Lyric0423/tianyuandifang/要求.md

请大家设计一个亚克力板的结构，具体要求如下：

1. 绘图要求：
要求画出“圆和方”。圆和方必须是同心的，但相不相交随意（可以是独立的，也可以是内接或外切的），大小不限。但是，最后做出来的结果至少要比较显著，因为画得太小也不好做。别说“陈老师，我最后用方头笔杵一下就算是方”，这不行，是要走出轨迹来的。

2. 电机配置：
因为是两个同学合作，一共有 4 个电机。你们用 2~3 个电机即可，具体配置可以是“两个步进电机加一个舵机”，也可以是“两个舵机加一个步进电机”，随便你们安排。

3. 操作工具：
完成的目标是操作一支笔或者笔芯。如果你自己有，随便用什么笔都可以。但除了那些“耍赖”的（比如毛笔之类的不算），必须使用正常的硬笔，具体是圆珠笔、水笔、铅笔都行。

4. 材料要求：
用的材料还是我们前面用过的那种，2.7mm 左右的亚克力板。一共是有两次机会。整个完成过程，包括下星期和下下星期，都是我们在课堂里的制作过程。

(a) 亚克力板：在加工之前，我会用千分尺测量好大概的尺寸给大家。
(b) 螺母和螺杆：允许使用，由我会提供。都是 3mm 的（叫 M3），长度有 1cm、2cm、3cm、4cm 的我都有。
(c) 橡皮筋：允许使用。
(d) 热熔胶：允许使用我们刚才用的热熔胶。
(e) 自备胶带和胶水：这次允许大家自备。

作业/第二次作业/Gear+Bar.dxf
这是一套齿轮和齿条，供参考。其中齿轮的轴就是步进电机的轴。

当然，还是那句话，允许你使用，但别太过分！你别跟陈老师说：“那亚克力板我就不用了，我全用热熔胶，一节课我就用一胶，垒出一个结构来。”别太过分，适可而止，让我还是能看得到你是拿亚克力板做的东西。你别跟陈老师说：“我热熔胶上粘了一小块亚克力，意思一下。”你别太过分，别的都行。

希望大家画出来的作品能够有完成度，就是画出来的圆和方看起来就是圆和方，越方越好，越圆越好。你别画出来的圆像方，画出来的方像圆，最后还跟陈老师说：“你看着办，哪个算是圆都行。”那不行啊，你要能让肉眼看得清楚是什么。

关于评分标准：
1. 创新部分：别出心裁的想法占 30 分。
2. 完成度部分：占 70 分。
换句话说，就算你最后没有达成目标，但是你的想法挺不错的，那在创新和创意想法这块占的分会比较高的，别太担心啊，别太担心。

最后，关于具体怎么做，我不做限制：
1. 不限制画的尺寸，几厘米到几十厘米都允许。
2. 但你别跟陈老师说：“我这车在这个房间里面走了一圈，然后在地上画了一个大大的圆，再画了一个大大的方。”我做了一个小车子，拖着一根笔在地上走。但别太过分啊，画的范围大概是一张 A4 纸，最多 A3 纸。A4 纸我当然多的是，A3 纸我们也能供得上。大概就是这么一个背景。

好，对于这个题，各位同学先问一下有没有问题？现在有疑惑的地方随时举手。

有没有 M3（直径 3mm）的？你说可以操作计算机，但机械的部分最好不要动，因为最后还是要拍录像的。

我也跟大家说一下去年完成的情况：
1. 有厉害的同学做完了之后，是完全不用操作的，车子自己就能在那跑完。
2. 有的同学因为车子绕一圈的时候线会打结，最后就抱着个笔记本跟着车转过去。

所以，后来我们在正式测量的时候定了一个规矩：你可以抱着笔记本走一圈。或者，你也可以动点脑筋，把线设计得完全不打结。但是，你的线必须是软的状态。你别最后是拎着个东西走了一个方，那是不行的啊，线得是软的，听明白了吗？

整个绘制过程要求最长 10 分钟。就是为了避免大家说“陈老师你等着，你等着”，等到下课的时候还在那走，那不行啊。最后录像你不能给我看一个超过 10 分钟的视频。

关于轨道，什么叫轨道呢？意思就是你可以在亚克力板上面掏一个圆或者方的槽，然后一根笔是松的，就这么沿着槽走一圈，把亚克力板当做尺子一样来用。这样是可以的，都可以。

还有几种特例情况我们先说清楚。我开学的时候跟大家说过，你必须得用一张普通的纸。普通的纸什么意思呢？你不能说“陈老师，我从网上随便找了一张一面是光面的纸”。我用刀在这个纸上刻了一个槽，然后拿支笔，哎呀好粗好粗地在上面“刷刷刷”刷，反正有槽的地方就有印子，这种是不行的，不允许啊！我要能看得到，你是确实按照圆和方去走的。

就这样啊，你说可以不用给笔记本供电，觉得拖着 USB 线太麻烦，要找个充电宝，这个是可以的。这次的样例，固件还是有要求的。这次给的尺寸比上次大一倍，接近 20cm×20cm，大概就是这么方，尺寸大一点，但仍然是有限制的啊！设计得渣的话还是放不下的。

你说必须什么？圆和方必须是同心的。具体是圆在外、方在外都可以，相不相交都可以。怎么了？橡皮泥是那种好像 3mm 宽的橡皮筋，我等会儿可以给你个样。你可以接啊，数量不限，什么都没有限制。但还是那句话，别太过分！你别说：“陈老师，你给我一吨。”还是有 2mm 的限制啊，还是 2mm。

你说老师，全程这个笔只能安装在设施的一个地方，还是允许画一半把笔拆下来，安在另外一个地方？

整个画的过程，机械的部分手不准碰，浩浩啊，手不准碰！但是，如果你说这个系统里面就是要两支笔，你同时装了两支笔，可以明白我的意思吗？动的时候，你可以碰电线的部分，但是不能去动机械的部分啊。

还有什么好的，大家有疑问的话还可以在群里面继续问啊。现在我们正常分组，来看看大家，祝愿一下，希望分到一个强有力的队友。
