Lyric0423/tianyuandifang/XY绘图机/图纸/02_编号排版.png

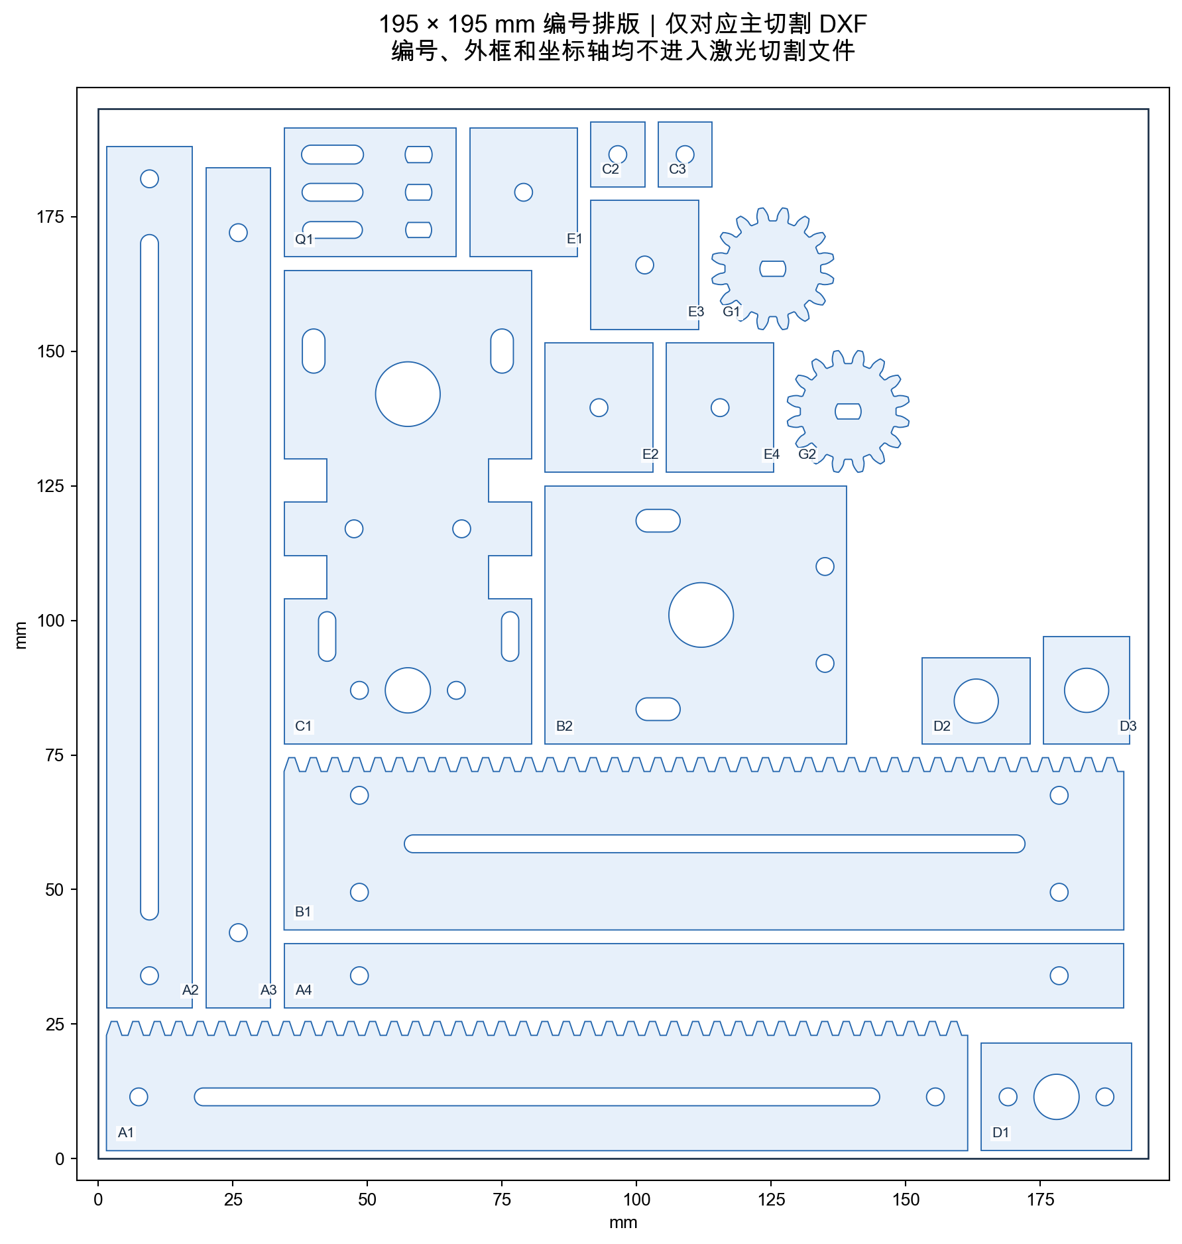
XY绘图机/图纸/02_编号排版.png
