Lyric0423/tianyuandifang/微信图片_20261104220640_549_7188.png

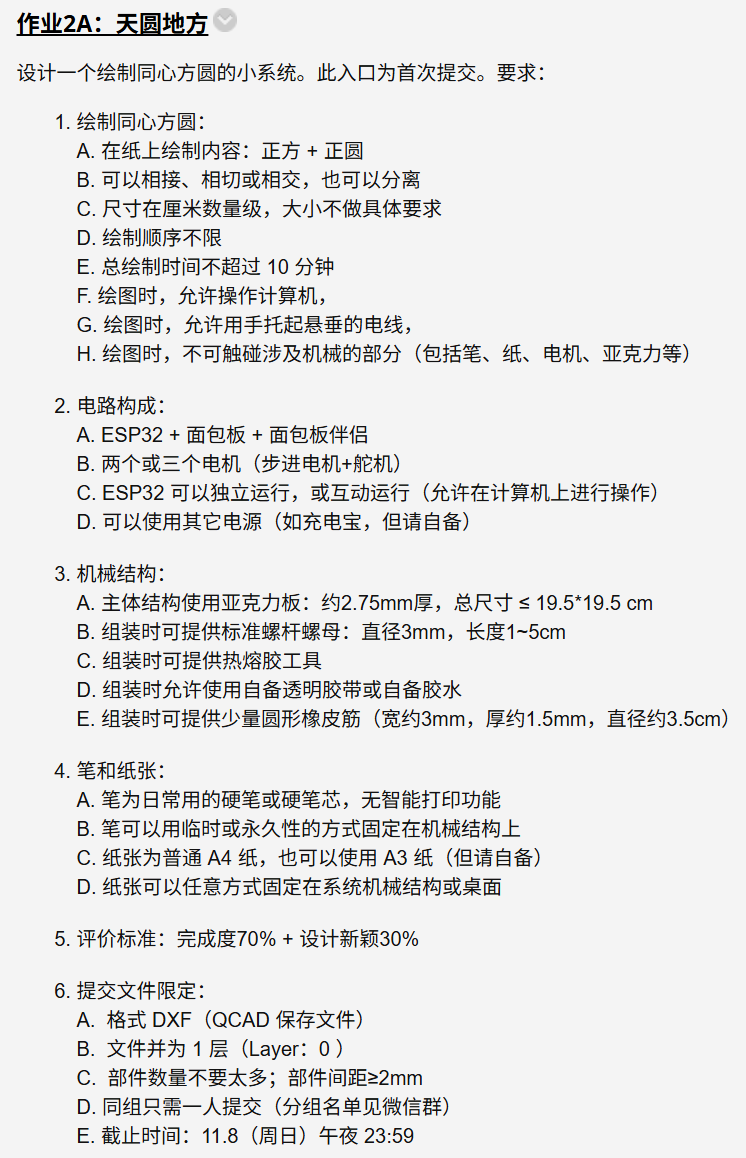
微信图片_20261104220640_549_7188.png
