Lyric0423/tianyuandifang/XY绘图机/图纸/零件孔位.csv

编号 | 名称 | 外包长mm | 外包宽mm | 孔号 | 孔类型 | 局部坐标与尺寸mm | 装配备注
A1 | Y左齿条导轨 | 160 | 24 | 1 | slot | {"type": "slot", "start": [18, 10], "end": [142, 10], "width": 3.3} | 安装时旋转90°，齿朝左；导槽位于全局x=14
A1 | Y左齿条导轨 | 160 | 24 | 2 | circle | {"type": "circle", "x": 6, "y": 10, "diameter": 3.3} | 安装时旋转90°，齿朝左；导槽位于全局x=14
A1 | Y左齿条导轨 | 160 | 24 | 3 | circle | {"type": "circle", "x": 154, "y": 10, "diameter": 3.3} | 安装时旋转90°，齿朝左；导槽位于全局x=14
A2 | Y右导轨 | 160 | 16 | 1 | slot | {"type": "slot", "start": [18, 8], "end": [142, 8], "width": 3.3}
A2 | Y右导轨 | 160 | 16 | 2 | circle | {"type": "circle", "x": 6, "y": 8, "diameter": 3.3}
A2 | Y右导轨 | 160 | 16 | 3 | circle | {"type": "circle", "x": 154, "y": 8, "diameter": 3.3}
A3 | 前后横向连接条 | 156 | 12 | 1 | circle | {"type": "circle", "x": 14, "y": 6, "diameter": 3.3}
A3 | 前后横向连接条 | 156 | 12 | 2 | circle | {"type": "circle", "x": 144, "y": 6, "diameter": 3.3}
A4 | 前后横向连接条 | 156 | 12 | 1 | circle | {"type": "circle", "x": 14, "y": 6, "diameter": 3.3}
A4 | 前后横向连接条 | 156 | 12 | 2 | circle | {"type": "circle", "x": 144, "y": 6, "diameter": 3.3}
B1 | X齿条横梁 | 156 | 32 | 1 | slot | {"type": "slot", "start": [24, 16], "end": [136, 16], "width": 3.3} | X导槽兼横梁；四个端部孔装Y滑动销；左侧导销同时穿过B2
B1 | X齿条横梁 | 156 | 32 | 2 | circle | {"type": "circle", "x": 14, "y": 7, "diameter": 3.3} | X导槽兼横梁；四个端部孔装Y滑动销；左侧导销同时穿过B2
B1 | X齿条横梁 | 156 | 32 | 3 | circle | {"type": "circle", "x": 14, "y": 25, "diameter": 3.3} | X导槽兼横梁；四个端部孔装Y滑动销；左侧导销同时穿过B2
B1 | X齿条横梁 | 156 | 32 | 4 | circle | {"type": "circle", "x": 144, "y": 7, "diameter": 3.3} | X导槽兼横梁；四个端部孔装Y滑动销；左侧导销同时穿过B2
B1 | X齿条横梁 | 156 | 32 | 5 | circle | {"type": "circle", "x": 144, "y": 25, "diameter": 3.3} | X导槽兼横梁；四个端部孔装Y滑动销；左侧导销同时穿过B2
B2 | Y电机侧挂板 | 56 | 48 | 1 | circle | {"type": "circle", "x": 28.98732318685386, "y": 24, "diameter": 12} | 装到B1上表面：左下角位于横梁局部(-38,-8)，两孔与B1左侧导销孔共用；结合面少量胶固定
B2 | Y电机侧挂板 | 56 | 48 | 2 | slot | {"type": "slot", "start": [18.98732318685386, 6.5], "end": [22.98732318685386, 6.5], "width": 4.2} | 装到B1上表面：左下角位于横梁局部(-38,-8)，两孔与B1左侧导销孔共用；结合面少量胶固定
B2 | Y电机侧挂板 | 56 | 48 | 3 | slot | {"type": "slot", "start": [18.98732318685386, 41.5], "end": [22.98732318685386, 41.5], "width": 4.2} | 装到B1上表面：左下角位于横梁局部(-38,-8)，两孔与B1左侧导销孔共用；结合面少量胶固定
B2 | Y电机侧挂板 | 56 | 48 | 4 | circle | {"type": "circle", "x": 52, "y": 15, "diameter": 3.3} | 装到B1上表面：左下角位于横梁局部(-38,-8)，两孔与B1左侧导销孔共用；结合面少量胶固定
B2 | Y电机侧挂板 | 56 | 48 | 5 | circle | {"type": "circle", "x": 52, "y": 33, "diameter": 3.3} | 装到B1上表面：左下角位于横梁局部(-38,-8)，两孔与B1左侧导销孔共用；结合面少量胶固定
C1 | X滑动笔架 | 46 | 88 | 1 | circle | {"type": "circle", "x": 13, "y": 40, "diameter": 3.3} | 长边沿Y；四个侧缺口避让Y导销头。导销孔(13,40)/(33,40)，笔孔(23,10)
C1 | X滑动笔架 | 46 | 88 | 2 | circle | {"type": "circle", "x": 33, "y": 40, "diameter": 3.3} | 长边沿Y；四个侧缺口避让Y导销头。导销孔(13,40)/(33,40)，笔孔(23,10)
C1 | X滑动笔架 | 46 | 88 | 3 | circle | {"type": "circle", "x": 23, "y": 10, "diameter": 8.4} | 长边沿Y；四个侧缺口避让Y导销头。导销孔(13,40)/(33,40)，笔孔(23,10)
C1 | X滑动笔架 | 46 | 88 | 4 | circle | {"type": "circle", "x": 14, "y": 10, "diameter": 3.3} | 长边沿Y；四个侧缺口避让Y导销头。导销孔(13,40)/(33,40)，笔孔(23,10)
C1 | X滑动笔架 | 46 | 88 | 5 | circle | {"type": "circle", "x": 32, "y": 10, "diameter": 3.3} | 长边沿Y；四个侧缺口避让Y导销头。导销孔(13,40)/(33,40)，笔孔(23,10)
C1 | X滑动笔架 | 46 | 88 | 6 | slot | {"type": "slot", "start": [8, 17], "end": [8, 23], "width": 3.2} | 长边沿Y；四个侧缺口避让Y导销头。导销孔(13,40)/(33,40)，笔孔(23,10)
C1 | X滑动笔架 | 46 | 88 | 7 | slot | {"type": "slot", "start": [42, 17], "end": [42, 23], "width": 3.2} | 长边沿Y；四个侧缺口避让Y导销头。导销孔(13,40)/(33,40)，笔孔(23,10)
C1 | X滑动笔架 | 46 | 88 | 8 | circle | {"type": "circle", "x": 23, "y": 65.01267681314614, "diameter": 12} | 长边沿Y；四个侧缺口避让Y导销头。导销孔(13,40)/(33,40)，笔孔(23,10)
C1 | X滑动笔架 | 46 | 88 | 9 | slot | {"type": "slot", "start": [5.5, 71.01267681314614], "end": [5.5, 75.01267681314614], "width": 4.2} | 长边沿Y；四个侧缺口避让Y导销头。导销孔(13,40)/(33,40)，笔孔(23,10)
C1 | X滑动笔架 | 46 | 88 | 10 | slot | {"type": "slot", "start": [40.5, 71.01267681314614], "end": [40.5, 75.01267681314614], "width": 4.2} | 长边沿Y；四个侧缺口避让Y导销头。导销孔(13,40)/(33,40)，笔孔(23,10)
C2 | X滑动垫片 | 10 | 12 | 1 | circle | {"type": "circle", "x": 5, "y": 6, "diameter": 3.3} | 各一片固定于C1底部两个导销孔处；固定结合面再垫约0.30mm胶带，使笔架高于B2
C3 | X滑动垫片 | 10 | 12 | 1 | circle | {"type": "circle", "x": 5, "y": 6, "diameter": 3.3} | 各一片固定于C1底部两个导销孔处；固定结合面再垫约0.30mm胶带，使笔架高于B2
D1 | 上层笔导向环 | 28 | 20 | 1 | circle | {"type": "circle", "x": 14, "y": 10, "diameter": 8.4} | M3立柱固定在C1笔孔两侧；上下导向孔保持同轴，间隔约20mm
D1 | 上层笔导向环 | 28 | 20 | 2 | circle | {"type": "circle", "x": 5, "y": 10, "diameter": 3.3} | M3立柱固定在C1笔孔两侧；上下导向孔保持同轴，间隔约20mm
D1 | 上层笔导向环 | 28 | 20 | 3 | circle | {"type": "circle", "x": 23, "y": 10, "diameter": 3.3} | M3立柱固定在C1笔孔两侧；上下导向孔保持同轴，间隔约20mm
D2 | 笔身限位/抬笔环 | 20 | 16 | 1 | circle | {"type": "circle", "x": 10, "y": 8, "diameter": 8.2} | 套在笔上，用胶带形成止挡；D2供舵盘从下方托起
D3 | 笔身限位/抬笔环 | 20 | 16 | 1 | circle | {"type": "circle", "x": 10, "y": 8, "diameter": 8.2} | 套在笔上，用胶带形成止挡；D2供舵盘从下方托起
E1 | 底脚垫 | 24 | 20 | 1 | circle | {"type": "circle", "x": 12, "y": 10, "diameter": 3.3}
E2 | 底脚垫 | 24 | 20 | 1 | circle | {"type": "circle", "x": 12, "y": 10, "diameter": 3.3}
E3 | 底脚垫 | 24 | 20 | 1 | circle | {"type": "circle", "x": 12, "y": 10, "diameter": 3.3}
E4 | 底脚垫 | 24 | 20 | 1 | circle | {"type": "circle", "x": 12, "y": 10, "diameter": 3.3}
G1 | 参考原轮廓16齿齿轮 | 22.594264798631002 | 22.594264798631116 | 1 | double_D | {"type": "double_D", "x": 11.297132399315501, "y": 11.297132399315558, "diameter": 4.8, "flats": 2.8} | 外形与老师参考文件相同；双扁孔4.8×2.8，先试切验证实轴
G2 | 参考原轮廓16齿齿轮 | 22.594264798631002 | 22.594264798631116 | 1 | double_D | {"type": "double_D", "x": 11.297132399315501, "y": 11.297132399315558, "diameter": 4.8, "flats": 2.8} | 外形与老师参考文件相同；双扁孔4.8×2.8，先试切验证实轴
Q1 | 孔槽试切片 | 32 | 24 | 1 | slot | {"type": "slot", "start": [5, 5], "end": [13, 5], "width": 3.1} | 左：槽宽3.1/3.3/3.5；右：双扁孔4.8×2.8/4.9×2.9/5.0×3.0（由下到上）
Q1 | 孔槽试切片 | 32 | 24 | 2 | slot | {"type": "slot", "start": [5, 12], "end": [13, 12], "width": 3.3} | 左：槽宽3.1/3.3/3.5；右：双扁孔4.8×2.8/4.9×2.9/5.0×3.0（由下到上）
Q1 | 孔槽试切片 | 32 | 24 | 3 | slot | {"type": "slot", "start": [5, 19], "end": [13, 19], "width": 3.5} | 左：槽宽3.1/3.3/3.5；右：双扁孔4.8×2.8/4.9×2.9/5.0×3.0（由下到上）
Q1 | 孔槽试切片 | 32 | 24 | 4 | double_D | {"type": "double_D", "x": 25, "y": 5, "diameter": 4.8, "flats": 2.8} | 左：槽宽3.1/3.3/3.5；右：双扁孔4.8×2.8/4.9×2.9/5.0×3.0（由下到上）
Q1 | 孔槽试切片 | 32 | 24 | 5 | double_D | {"type": "double_D", "x": 25, "y": 12, "diameter": 4.9, "flats": 2.9} | 左：槽宽3.1/3.3/3.5；右：双扁孔4.8×2.8/4.9×2.9/5.0×3.0（由下到上）
Q1 | 孔槽试切片 | 32 | 24 | 6 | double_D | {"type": "double_D", "x": 25, "y": 19, "diameter": 5.0, "flats": 3.0} | 左：槽宽3.1/3.3/3.5；右：双扁孔4.8×2.8/4.9×2.9/5.0×3.0（由下到上）
