Lyric0423/tianyuandifang/Gear+Bar.dxf

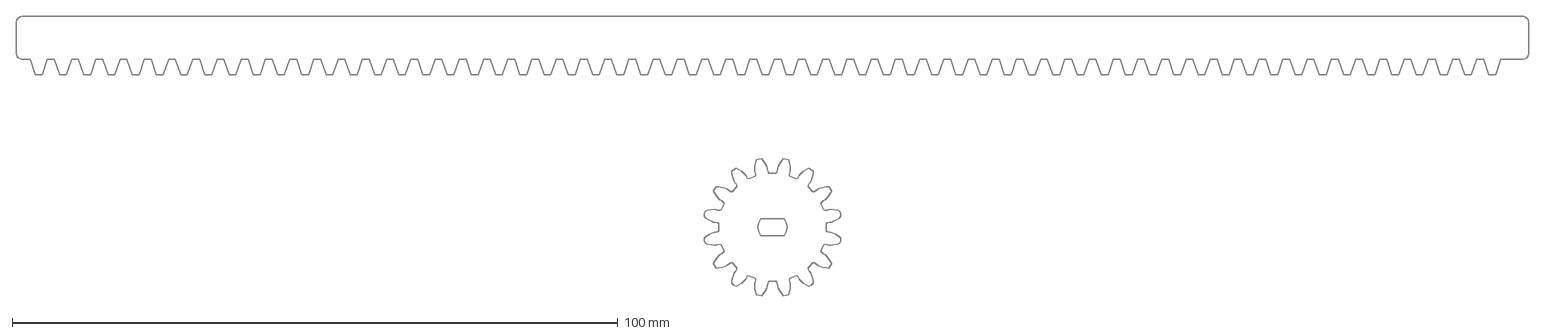
[picture p5: CAD file, 2026-11-07]
Gear+Bar.dxf
249.7 x 46.1 mm
