Lyric0423/tianyuandifang/XY绘图机/图纸/01_提交切割_195x195_Layer0.dxf

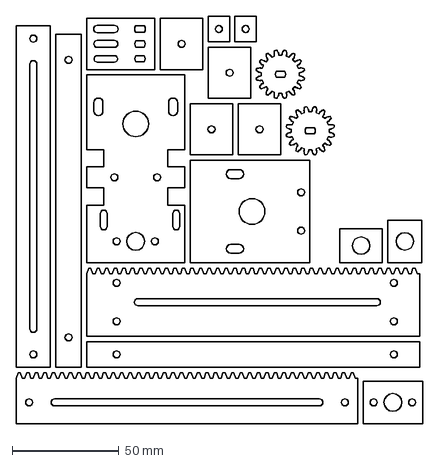
[picture p6: CAD file, 2026-11-07]
XY绘图机/图纸/01_提交切割_195x195_Layer0.dxf
190.5 x 191.0 mm
