Lyric0423/tianyuandifang/XY绘图机/图纸/04_单独试切_Q1_不要重复排版.dxf

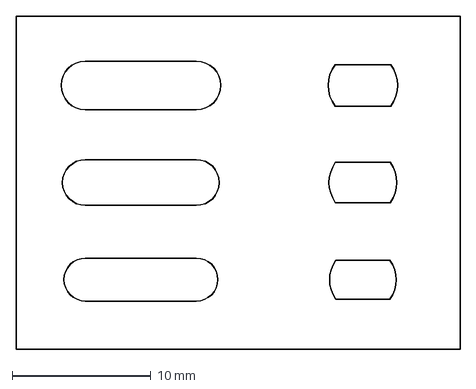
[picture p7: CAD file, 2026-11-07]
XY绘图机/图纸/04_单独试切_Q1_不要重复排版.dxf
32.0 x 24.0 mm
